alislaboratory/CARDio/(list of files, drawings)

Other design files:
Rev3.0/SCH_ECG-business-card_2025-07-31.json
